timotto/battalarm/docs/user_manual/src/assets/charging_720.jpg

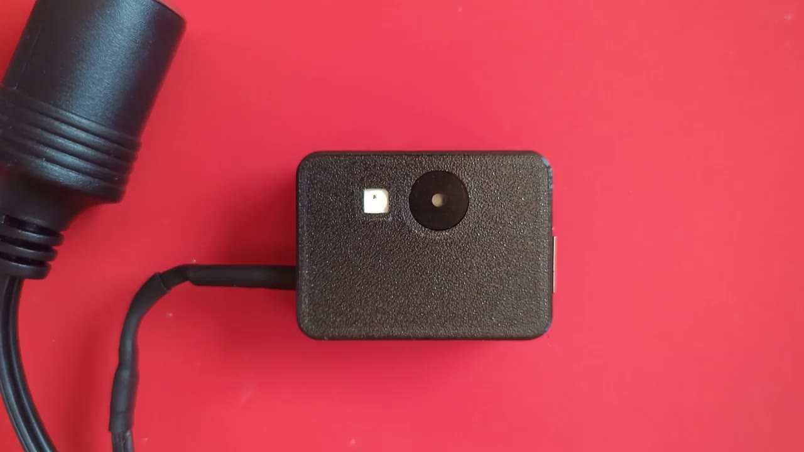
docs/user_manual/src/assets/charging_720.jpg
