timotto/battalarm/docs/user_manual/src/assets/base_station_4x3_320.jpg

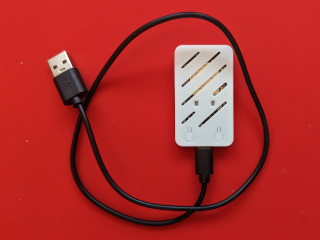
docs/user_manual/src/assets/base_station_4x3_320.jpg
