timotto/battalarm/hardware/pcb_mobile/README.md

# Battery Alarm Mobile Device PCB

This is the PCB used by the alarm devices mounted in the vehicle.

It is designed to be etched at home or milled with a cheap CNC router.
