timotto/battalarm/hardware/case_mobile/bottom.stl

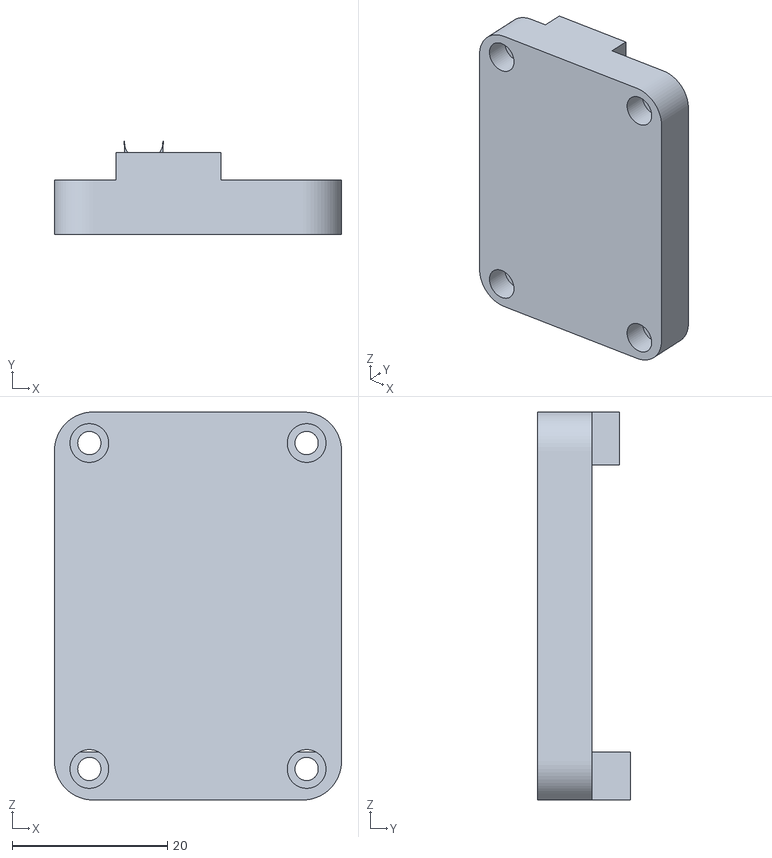
[picture p3: CAD file, 2024-08-15]
hardware/case_mobile/bottom.stl
37.0 x 12.0 x 50.0
