timotto/battalarm/hardware/case_mobile/top.stl

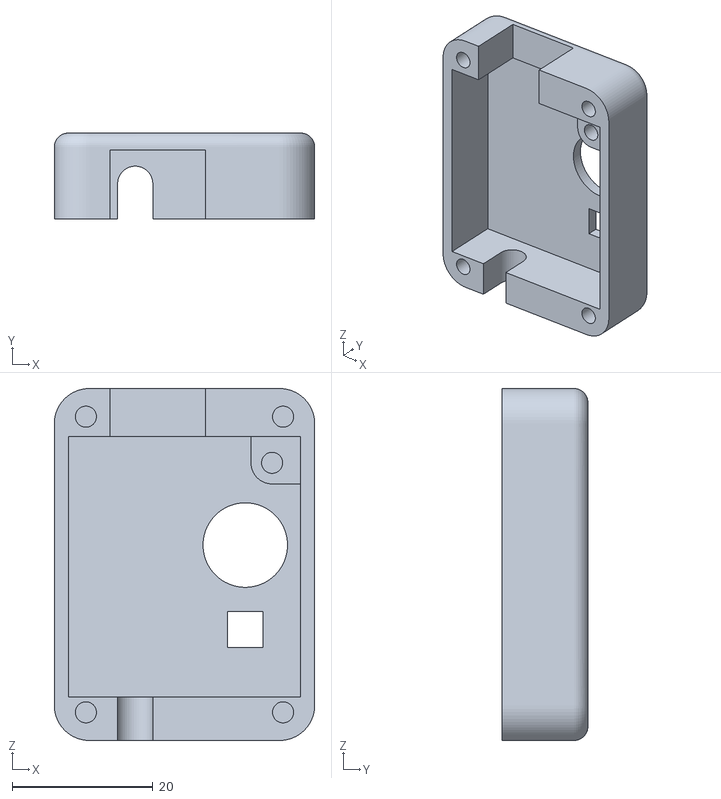
[picture p4: CAD file, 2024-08-15]
hardware/case_mobile/top.stl
37.0 x 12.2 x 50.0
