timotto/battalarm/docs/user_manual/src/assets/adapter_3d.png

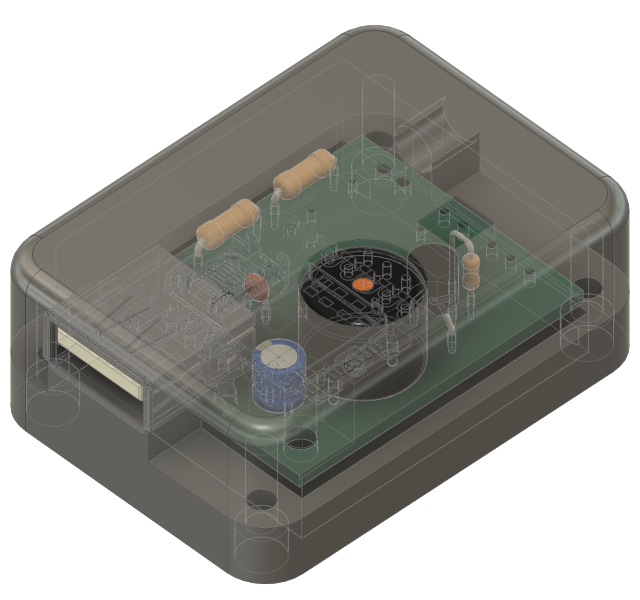
docs/user_manual/src/assets/adapter_3d.png
