timotto/battalarm/docs/user_manual/src/assets/adapter_4x3_320.jpg

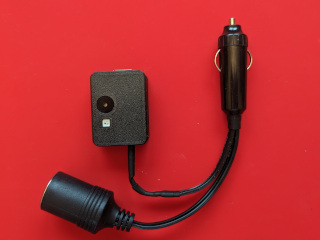
docs/user_manual/src/assets/adapter_4x3_320.jpg
