timotto/battalarm/docs/user_manual/src/assets/alert_720.jpg

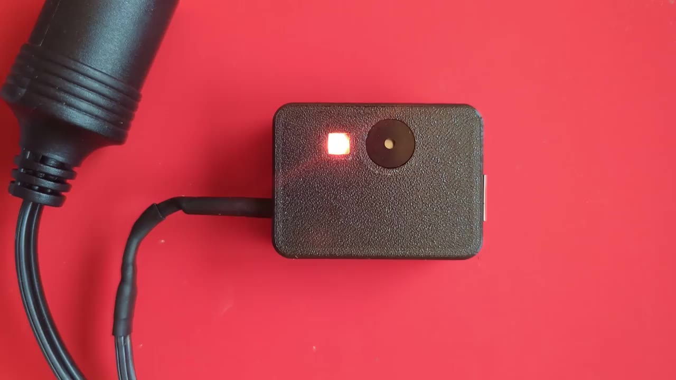
docs/user_manual/src/assets/alert_720.jpg
