timotto/battalarm/docs/user_manual/src/assets/app_settings.png

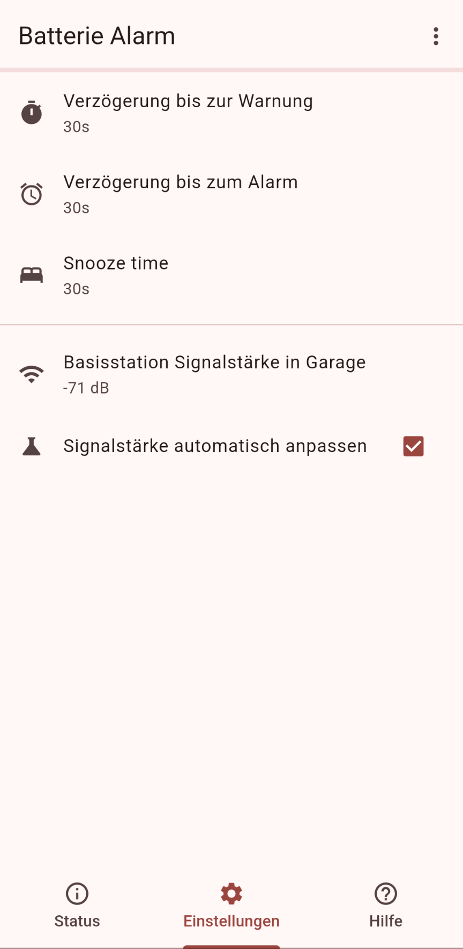
docs/user_manual/src/assets/app_settings.png
