timotto/battalarm/docs/user_manual/src/assets/app_status.png

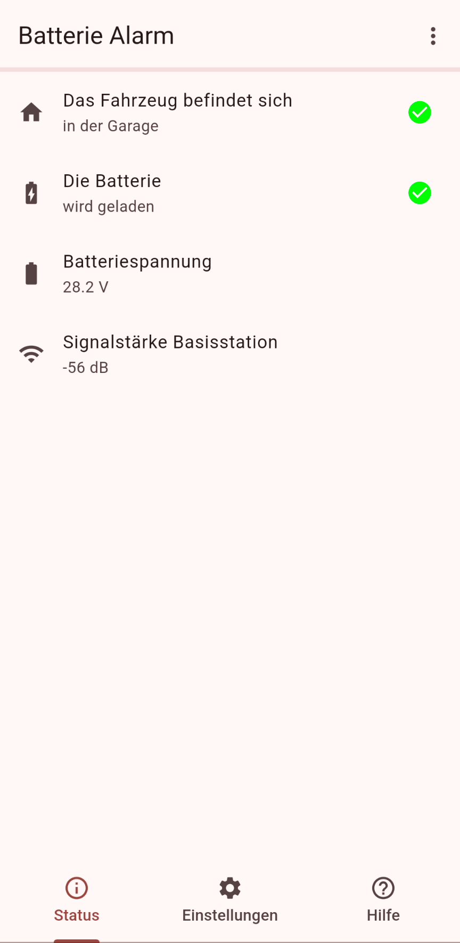
docs/user_manual/src/assets/app_status.png
