timotto/battalarm/docs/user_manual/src/assets/bluetooth_720.jpg

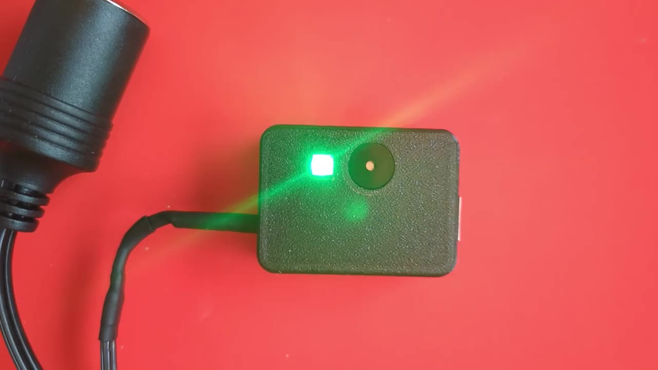
docs/user_manual/src/assets/bluetooth_720.jpg
