timotto/battalarm/docs/user_manual/src/assets/in_garage_720.jpg

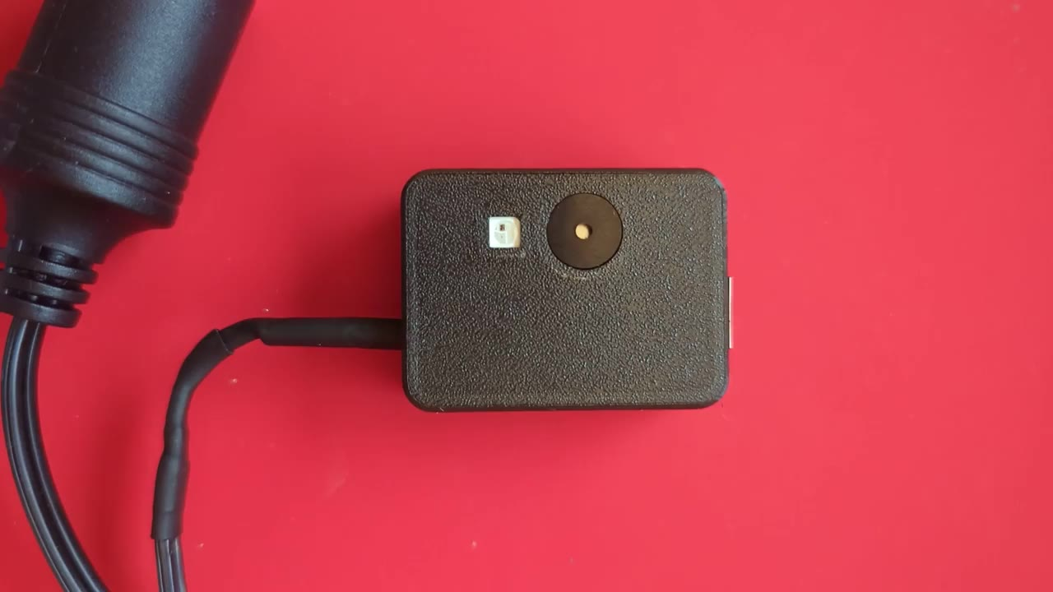
docs/user_manual/src/assets/in_garage_720.jpg
