timotto/battalarm/docs/user_manual/src/assets/power_on_720.jpg

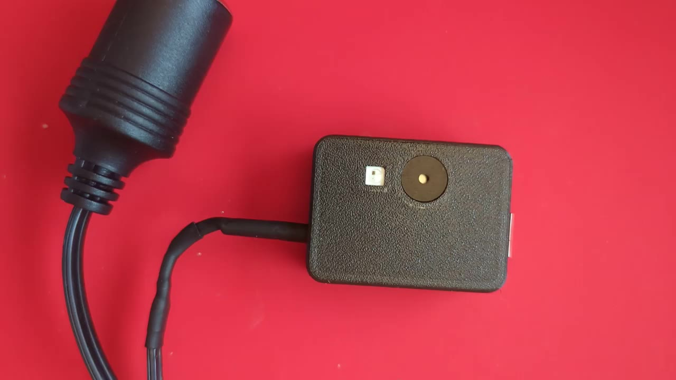
docs/user_manual/src/assets/power_on_720.jpg
