timotto/battalarm/docs/user_manual/src/assets/snooze_720.jpg

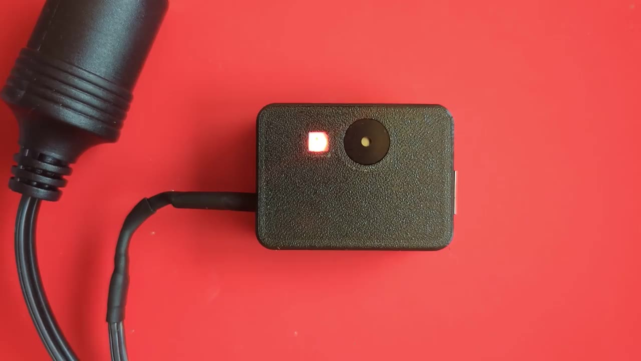
docs/user_manual/src/assets/snooze_720.jpg
