timotto/battalarm/docs/user_manual/src/assets/warning_720.jpg

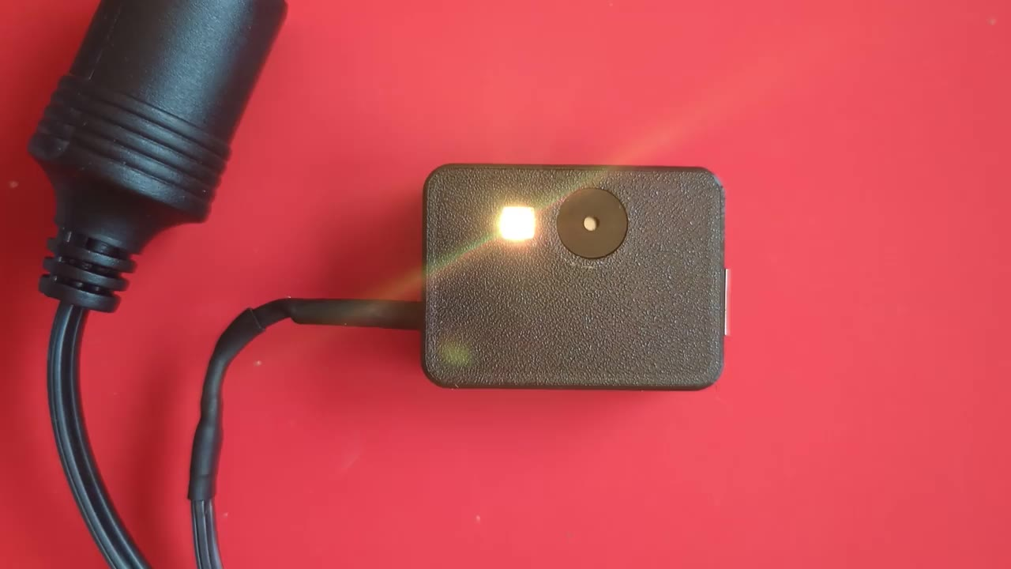
docs/user_manual/src/assets/warning_720.jpg
