timotto/battalarm/hardware/pcb_mobile/pcb_mobile.kicad_pcb

## KiCad design hardware/pcb_mobile/pcb_mobile.kicad_pcb (2024-08-15)

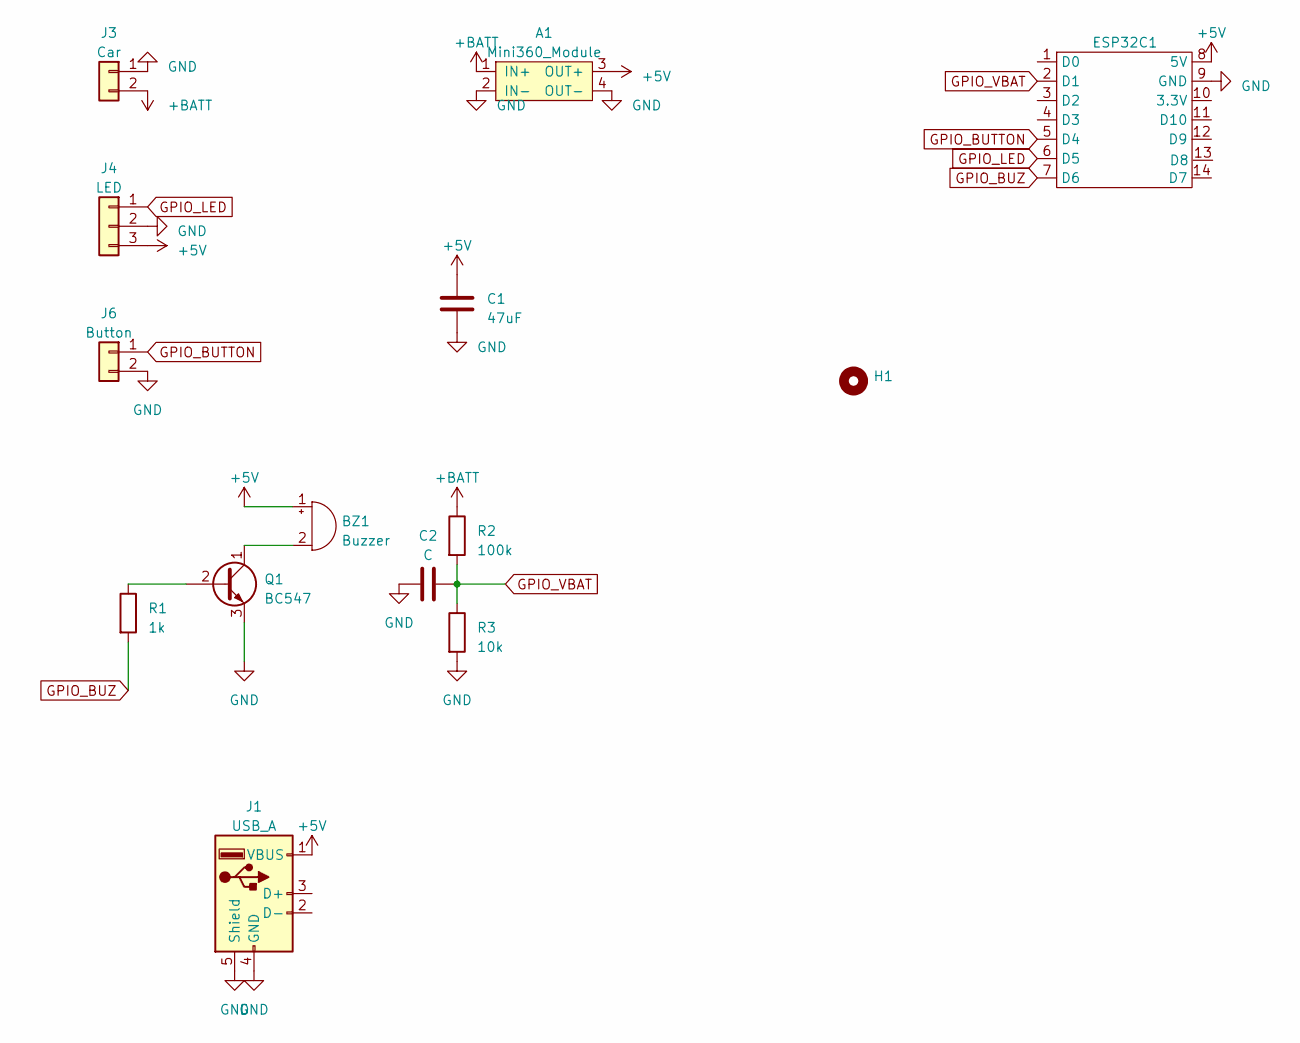
[picture p15: schematic pcb_mobile.kicad_sch]

Parts:
A1: Mini360_Module
BZ1: Buzzer; Buzzer_12x9.5RM7.6
C1: 47uF; CP_Radial_D5.0mm_P2.50mm
C2: C; C_Disc_D3.0mm_W2.0mm_P2.50mm
ESP32C1: XIAO_ESP32C3_1
H1: MountingHole_3.2mm_M3
J1: USB_A; USB_A_Molex_67643_Horizontal
J3: Car; PinHeader_1x02_P2.54mm_Vertical
J4: LED; PinHeader_1x03_P2.54mm_Vertical
J6: Button; PinHeader_1x02_P2.54mm_Vertical
Q1: BC547; TO-92_Wide
R1: 1k; R_Axial_DIN0204_L3.6mm_D1.6mm_P2.54mm_Vertical
R2: 100k; R_Axial_DIN0207_L6.3mm_D2.5mm_P7.62mm_Horizontal
R3: 10k; R_Axial_DIN0207_L6.3mm_D2.5mm_P7.62mm_Horizontal

Connections:
+5V: A1.3 (OUT+), BZ1.1 (-), C1.1, ESP32C1.8 (5V), J1.1 (VBUS), J4.3
+BATT: A1.1 (IN+), J3.2, R2.1
GND: A1.2 (IN-), A1.4 (OUT-), C1.2, C2.1, ESP32C1.9 (GND), J1.4 (GND), J1.5 (Shield), J3.1, J4.2, J6.2, Q1.3 (E), R3.2
GPIO_BUTTON: ESP32C1.5 (D4), J6.1
GPIO_BUZ: ESP32C1.7 (D6), R1.2
GPIO_LED: ESP32C1.6 (D5), J4.1
GPIO_VBAT: C2.2, ESP32C1.2 (D1), R2.2, R3.1
unnamed: BZ1.2 (+), Q1.1 (C)
unnamed: Q1.2 (B), R1.1

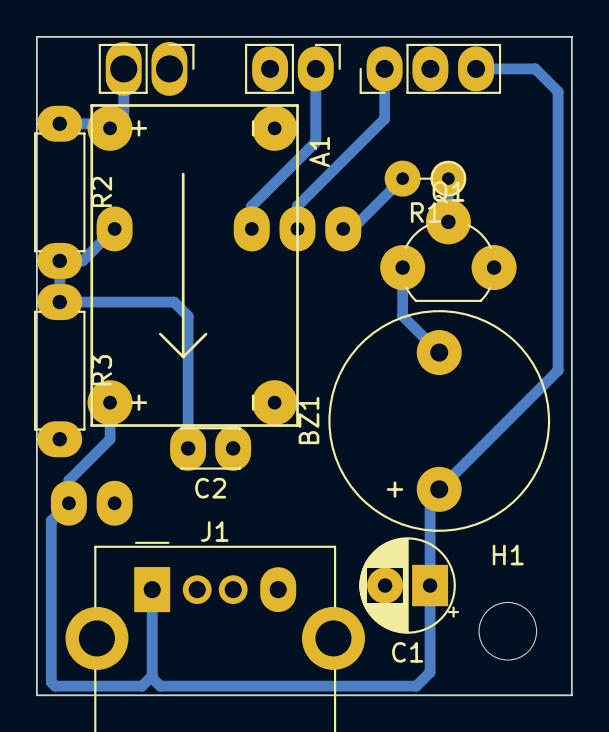
[picture p16: board pcb_mobile.kicad_pcb from above]

Board: 2 copper layers, 29.7 x 36.6 mm, 14 parts (1 on the bottom side), 9 nets.
