timotto/battalarm/battery_alarm_firmware_mobile/vbat.ino

#include "config.h"

float _vbat_volt = 0;
float _vbat_voltLp = 0;
float _vbat_voltDelta = 0;
bool _vbat_voltFirst = true;
bool _vbat_charging = false;
bool _vbat_engineRunning = false;

bool _vbat_debug = false;
float _vbat_fakeVoltageValue = 1;
bool _vbat_fakeVoltageEnabled = false;

void vbat_status() {
  Serial.printf(
    "VBat status:\n"
    "  Volt (last): %.1f\n"
    "  Volt (lp): %.1f\n"
    "  Delta: %.2f\n"
    ,
    _vbat_volt, _vbat_voltLp, _vbat_voltDelta
  );
}

bool vbat_isCharging() {
  return _vbat_charging;
}

bool vbat_isEngineRunning() {
  return _vbat_engineRunning;
}

void vbat_fake_voltage(float value) {
  _vbat_fakeVoltageValue = value;
  _vbat_fakeVoltageEnabled = true;
}

void vbat_fake_voltageOff() {
  _vbat_fakeVoltageEnabled = false;
}

float vbat_volt() {
  return _vbat_volt;
}

float vbat_voltLp() {
  return _vbat_voltLp;
}

float vbat_voltDelta() {
  return _vbat_voltDelta;
}

void vbat_debug() {
  _vbat_debug = true;
}

void vbat_debugOff() {
  _vbat_debug = false;
}

void setup_vbat() {

}

float _vbat_delta_ref = 0;

void loop_vbat(const uint32_t now) {
  _vbat_loop_read(now);
  _vbat_loop_delta(now);
  _vbat_loop_compute(now);
  _vbat_loop_debug(now);
}

void _vbat_loop_read(const uint32_t now) {
  static uint32_t last_time = 0;
  const uint32_t dt = now - last_time;
  if (dt < 20) return;
  last_time = now;

  if (_vbat_fakeVoltageEnabled) {
    _vbat_volt = _vbat_fakeVoltageValue;
    _vbat_voltLp = _vbat_fakeVoltageValue;
    _vbat_delta_ref = _vbat_fakeVoltageValue;
    return;
  }

  const uint16_t val = analogRead(PIN_VBAT);
  _vbat_volt = (float)val * VBAT_F * configVbatTuneF;

  if (_vbat_voltFirst) {
    _vbat_voltFirst = false;
    _vbat_voltLp = _vbat_volt;
    _vbat_delta_ref = _vbat_volt;
  }

  _vbat_voltLp = configVbatLpF * _vbat_voltLp + (1.0 - configVbatLpF) * _vbat_volt;
}

void _vbat_loop_delta(const uint32_t now) {
  static uint32_t last_time = 0;
  const uint32_t dt = now - last_time;
  if (dt < VBAT_DELTA_INTERVAL) return;
  last_time = now;

  const float delta = _vbat_voltLp - _vbat_delta_ref;
  _vbat_delta_ref = _vbat_voltLp;

  _vbat_voltDelta += delta;
  // reduce delta to 0 over time
  _vbat_voltDelta *= 1.0 - ((float)VBAT_DELTA_INTERVAL / (float)VBAT_DELTA_RESET);
}

void _vbat_loop_compute(const uint32_t now) {
  // charging
  static bool last_chargingState = false;
  static uint32_t last_chargingState_change = 0;

  const bool chargingState = _vbat_compute_charging_state();

  if (chargingState != last_chargingState) {
    last_chargingState = chargingState;
    last_chargingState_change = now;
  }

  if (_vbat_charging != chargingState) {
    const uint32_t dt = now - last_chargingState_change;
    if (dt > 1000) {
      _vbat_charging = chargingState;
    }
  }

  // engine running
  static bool last_engineRunningState = false;
  static uint32_t last_engineRunningState_change = 0;

  const bool engineRunningState = _vbat_compute_engineRunning_state();

  if (engineRunningState != last_engineRunningState) {
    last_engineRunningState = engineRunningState;
    last_engineRunningState_change = now;
  }

  if (_vbat_engineRunning != engineRunningState) {
    const uint32_t dt = now - last_engineRunningState_change;
    if (dt > 1000) {
      _vbat_engineRunning = engineRunningState;
    }
  }
}

void _vbat_loop_debug(const uint32_t now) {
  if (!_vbat_debug) return;

  static uint32_t last_time = 0;
  if (now - last_time < 1000) return;
  last_time = now;

  Serial.printf("vbat: volt=%.1f voltLp=%.1f delta=%.1f\n", _vbat_volt, _vbat_voltLp, _vbat_voltDelta);
}

bool _vbat_compute_charging_state() {
  // compute "is vehicle charging state"
  // compare the measured battery voltage with the configured thresholds for
  // - configVbatChargeDeltaThreshold
  // - configVbatAlternatorVoltage
  // a) the configured alternator voltage is higher than the charger voltage
  // b) the configured charger voltate is higher than the alternator voltage

  if (configVbatAlternatorVoltage > configVbatChargeDeltaThreshold) {
    // a)
    return
      (_vbat_voltLp < configVbatAlternatorVoltage)
      &&
      (
        (_vbat_voltLp >= configVbatChargeVoltage)
        ||
        (_vbat_voltDelta >= configVbatChargeDeltaThreshold)
      );
  } else {
    // b)
    return
      (_vbat_voltLp > configVbatAlternatorVoltage)
      &&
      (
        (_vbat_voltLp >= configVbatChargeVoltage)
        ||
        (_vbat_voltDelta >= configVbatChargeDeltaThreshold)
      );
  }
}

bool _vbat_compute_engineRunning_state() {
  if (configVbatAlternatorVoltage > configVbatChargeDeltaThreshold) {
    return _vbat_voltLp >= configVbatAlternatorVoltage;
  } else {
    return _vbat_voltLp >= configVbatAlternatorVoltage && _vbat_voltLp < configVbatChargeVoltage;
  }
}
