timotto/battalarm/(commit log)

2024-05-15 📡 beacon firmware
2024-05-15 🚒 vehicle firmware
2024-05-15 🧼 refactoring
2024-05-15 🔎 more bt rssi results
2024-05-15 🖨️ status output
2024-05-15 🎛️ bt config & status interface
2024-05-15 🔘 toggle bt visibility with button
2024-05-15 🔑 require bt bonding
2024-05-15 🔊 configure buzzer alert level
    [bt_config.ino, buzzer.ino, config.h, console.ino, pref.ino]
2024-05-17 🐞 fix bug
2024-05-17 🧽 refactoring
2024-05-17 😴 report low rssi when not in range
2024-05-17 🍪 pin config for ESP32C3
2024-05-17 😇 remove ble pairing code
2024-05-17 📱 settings config app
2024-05-17 🫴 handle ble exceptions
2024-05-17 💄 nicer scan list experience
2024-05-17 💾 fix missing pref
    [pref.ino]
2024-05-17 🔌 nicer connecting text
2024-05-17 💎 replace provider logic
2024-05-17 🚿 refactoring
2024-05-17 🖼️ app icon & name
2024-05-17 🙈 don't flicker "no bluetooth" when still checking
2024-05-18 🪧 show message on connection error
2024-05-18 🧢 indicate bluetooth activity
2024-05-18 💄 cosmetics
2024-05-18 🧴 cosmetics
2024-05-19 🔋 configure vbat fine tuning with app
2024-05-19 🧑‍🔬 hide rare config items in expert view
2024-05-19 📡 select beacon in app
2024-05-19 🤷 disable ibeacon so app can find the station
2024-05-19 🚦 switch led library
2024-05-20 🎁 add missing app assets
2024-05-20 🧑‍🦯 hide another expert setting
2024-05-20 ⚖️ show licenses in about app dialog
2024-05-20 🚀 setup fastlane for android
2024-05-20 🔧 fix android application id
2024-05-21 🖼️ new icon
2024-05-21 🤜 bump flutter to 3.22
2024-05-21 ✅ green checkmarks on status screen
2024-05-21 💡 make DeviceClient a singleton
2024-05-21 😊 apply current reading as config
2024-05-23 🔘 capacitive touch button is active high
2024-05-23 🤩 full-blown localized user manual with pictures and videos
2024-05-23 🔧 fix ci
2024-05-23 🚫 disable ng cli analytics
2024-05-23 🔨 fix chart
2024-05-23 🌎 build localized by default
2024-05-23 🥖 remove non-existing language
2024-05-23 🎢 app pipeline
2024-05-23 🔧 fix pipeline
2024-05-23 😔 the app has no tests
2024-05-23 🔢 use matching app build image version
2024-05-23 🪛 fix android lane names
2024-05-23 🎯 improve ci triggers
2024-05-23 🤜 bump android publish image
2024-05-23 😇 really fix android track names
2024-05-23 🔧 fix publish android image repository name
2024-05-23 📰 use localized page title
2024-05-23 🧹 cleanup
2024-05-23 📷 add app screenshots to docs
2024-05-23 📝 more intro text
2024-05-23 😅 switch translations to arb format
2024-05-23 📺 re-position screenshots
2024-05-23 🌍 localize app
2024-05-23 🎓 promote to closed testing automatically
2024-05-23 🖼️ update docs favicon
2024-05-23 📖 fix missing app translations
2024-05-23 🤜 upgrade to angular 18
2024-05-23 🔦 highlight active navigation item
2024-05-23 🖼️ add icons to navigation items
2024-05-23 🎥 view transitions
2024-05-23 🤤 put 3d rendering of adapter into introduction
2024-05-23 🤩 material-3 theme, sort of
2024-05-23 🤕 work around early angular adoption suffering
2024-05-23 🪧 redirect to introduction on empty route
2024-05-23 ⏳ don't use permanent redirect
2024-05-23 👊 auto-bump app version on prod release
2024-05-24 🎼 re-format pipeline
2024-05-24 🧑‍🦯 add missing image alt text
2024-05-24 🥰 replace primeng with own image viewer
2024-05-24 🖼️ layout
2024-05-24 📔 re-order chapters
2024-05-24 🪛 fix full screen image on mobile
2024-05-24 🤳 fix screenshot layout on mobile
2024-05-24 💰 don't preload videos
2024-05-24 🎬 add missing video posters
2024-05-25 ⚡️ configure alternator voltage
2024-05-25 🩹 don't crash on missing ble characteristics
2024-05-25 🙅 refuse to edit non existing config properties
2024-05-25 🌍 add missing translation
2024-05-25 🎭 allow to fake voltage instead of charging state
2024-05-25 🧮 include alternator voltage threshold in charging state computation
2024-05-25 ⏎ add required line feed
2024-05-25 🎉 ble ota device implementation
2024-05-25 🎢 firmware pipeline
2024-05-25 🦋 larger connecting animation
2024-05-25 🤕 improve ota error handling
    [bt_ota.ino]
2024-05-26 🧹 proper ota state handling
2024-05-26 🐛 fix bugs
2024-05-26 🙉 disable scanning during ota
2024-05-26 🥰 ota from app
2024-05-26 🌎 ota localization
2024-05-26 🤖 support android app language
2024-05-26 🇺🇸 disable app language support
2024-05-26 🦿 upgrade agp
2024-05-26 🇩🇪 re-enable android app language
2024-05-26 🪮 smooth flash eta
2024-05-26 🇺🇸 add missing translation
2024-05-27 🎨 re-design ota dialog
2024-05-27 🏃 skip android closed testing
2024-05-27 ☎️ android app uses internet permission
2024-05-27 ✍️ log errors details
2024-05-28 🌎 translations
2024-05-28 🕰️ show download eta
2024-05-28 📦 store compressed firmware artifact
2024-05-28 🚮 don't store uncompressed firmware artifact
2024-05-28 🎁 flash compressed firmware update
2024-05-28 🐛 fix bug
2024-05-28 🦟 fix bug
2024-05-28 🎢 accelerate pipeline
2024-05-30 🎬 show animation while scanning
2024-05-30 🐜 fix microbug
2024-05-30 🔢 show adapter version in ota dialog
2024-05-30 🙈 hide build number from version from non developers
2024-05-30 🥰 nicer connect screen animation
2024-05-30 🚨 forward errors during flashing
2024-05-30 📽️ another animation
2024-05-30 ⏹️ no animation when there are no results
2024-05-30 🛵 respect engine running state
2024-05-30 ⏳ toggle bluetooth with ultra long press
2024-06-01 🛀 refactoring
2024-06-01 📝 update device bluetooth instruction
2024-06-01 🖼️ support landscape status page
2024-06-01 🫰 edit numeric values with slider
2024-08-14 🎢 set ota url in pipeline
2024-08-15 ⚡️ alarm device pcb
    [pcb_mobile.kicad_pcb, pcb_mobile.kicad_sch]
2024-08-15 📦 alarm device case
    [bottom.stl, top.stl]
